voinescuvoinea/flatpack-oven/docs/concepts/estimates.md

# Concept estimates (generated by `geometry/concepts.py`, do not edit by hand)

Exchange rates: ECB euro foreign exchange reference rates, 2026-11-06: 1 EUR = 5.3403 RON = 1.1165 USD.

## Floor fit (round floor, fire taking 1/4 of the floor as in Falciano et al. 2022)
- Ø 0.90 m floor: fire segment depth 26.8 cm; largest clear circle beside it 63.2 cm,
  so a 45 cm pizza gets a 9.1 cm margin all round.

## Comparison

| | A | B | C |
|---|---|---|---|
| Concept | Steel-lined low dome | Firebrick barrel vault (sprung arch in a steel frame) | Cast refractory segment dome (home-cast in reusable moulds) |
| Refractory mass (kg) | 86 | 492 | 376 |
| Total estimated mass (kg) | 150 + hardware | 542 + hardware | 421 + hardware |
| Heaviest single part (kg) | 3.4 | 3.4 | 32.2 |
| Part count (approx.) | ~45 + fasteners | ~155 + fasteners | ~34 + fasteners |
| Stored heat at 450 °C, upper bound (MJ) | 40 | 229 | 175 |
| …as wood at F22 LHV and η (kg) | 2.8 | 15.8 | 12.1 |
| Priced items (USD) | 417 | 574 | 1259 |
| Unpriced items | inner liner; outer shell; laser cutting + bending of liner/shell; door | steel frame: angle buckstays + M12 tie rods; outer shell; door | moulds (plywood/EPS); outer shell; door |

## Line items

### A. Steel-lined low dome

Bolted stainless gores form a low dome over a firebrick floor; fibre insulation; painted steel outer shell. Like commercial portable ovens, scaled up.

Design parameters (proposals): `{'pizza_D_m': 0.45, 'door_w_m': 0.52, 'door_h_m': 0.24, 't_floor_brick_m': 0.064, 't_floor_casi_m': 0.05, 't_dome_sw_m': 0.075, 't_shell_m': 0.001, 'floor': 'round D 0.90 m', 'wall_h_m': 0.2, 'vault_rise_m': 0.2, 'liner_t_m': 0.0015}`

| Item | Qty | Mass (kg) | Cost (USD) |
|---|---|---|---|
| floor bricks (laid flat, 64 mm) | 25.0 pcs | 86.0 | 30 |
| floor insulation CaSi 2x25 mm | 3.0 sheets | 9.9 | 59 |
| inner liner, stainless 1.5 mm (8 gores + crown + door arch) | 1.6 m2 | 19.4 | quote needed |
| dome insulation Superwool 3x25 mm | 2.0 rolls | 18.0 | 313 |
| outer shell, steel 1 mm, painted | 2.1 m2 | 16.5 | quote needed |
| laser cutting + bending of liner/shell | 1.0 job | 0.0 | quote needed |
| refractory sealant | 2.0 cartridges | 0.0 | 16 |
| door, flue pipe, fasteners (A2 stainless) | 1.0 lot | 0.0 | quote needed |

### B. Firebrick barrel vault (sprung arch in a steel frame)

Local fireclay bricks dry-fitted on a reusable former, held by a bolted angle-iron frame with tie rods (kiln practice); fibre insulation; light outer shell.

Design parameters (proposals): `{'pizza_D_m': 0.45, 'door_w_m': 0.52, 'door_h_m': 0.24, 't_floor_brick_m': 0.064, 't_floor_casi_m': 0.05, 't_dome_sw_m': 0.075, 't_shell_m': 0.001, 'floor': 'rect 0.80 x 0.90 m, fire along back wall', 'wall_h_m': 0.15, 'vault_rise_m': 0.25, 'brick_t_m': 0.114, 'arch_radius_m': 0.445, 'arch_angle_deg': 128.0}`

| Item | Qty | Mass (kg) | Cost (USD) |
|---|---|---|---|
| floor bricks (laid flat, 64 mm) | 28.0 pcs | 96.3 | 34 |
| floor insulation CaSi 2x25 mm | 3.0 sheets | 11.2 | 59 |
| vault + walls, bricks (114 mm thick) | 115.0 pcs | 395.6 | 138 |
| dome insulation Superwool 3x25 mm | 2.0 rolls | 20.4 | 313 |
| steel frame: angle buckstays + M12 tie rods | 1.0 lot | 0.0 | quote needed |
| outer shell, steel 1 mm or cement board | 2.3 m2 | 18.7 | quote needed |
| refractory sealant / mortar for arch joints | 4.0 cartridges | 0.0 | 31 |
| door, flue pipe, fasteners | 1.0 lot | 0.0 | quote needed |

### C. Cast refractory segment dome (home-cast in reusable moulds)

8 dome segments + crown cast from dense castable in moulds (the commercial modular-kit approach); fibre insulation; outer shell or render.

Design parameters (proposals): `{'pizza_D_m': 0.45, 'door_w_m': 0.52, 'door_h_m': 0.24, 't_floor_brick_m': 0.064, 't_floor_casi_m': 0.05, 't_dome_sw_m': 0.075, 't_shell_m': 0.001, 'floor': 'round D 0.90 m', 'wall_h_m': 0.2, 'vault_rise_m': 0.2, 'shell_t_m': 0.08, 'segments': 9}`

| Item | Qty | Mass (kg) | Cost (USD) |
|---|---|---|---|
| floor bricks (laid flat, 64 mm) | 25.0 pcs | 86.0 | 30 |
| floor insulation CaSi 2x25 mm | 3.0 sheets | 9.9 | 59 |
| dome segments, dense castable 80 mm | 13.0 bags 25 kg | 290.1 | 834 |
| moulds (plywood/EPS), reinforcement needles | 1.0 lot | 0.0 | quote needed |
| dome insulation Superwool 3x25 mm | 2.0 rolls | 18.4 | 313 |
| outer shell, steel 1 mm or render on mesh | 2.1 m2 | 16.8 | quote needed |
| refractory sealant for segment joints | 3.0 cartridges | 0.0 | 24 |
| door, flue pipe, fasteners | 1.0 lot | 0.0 | quote needed |

## Notes on method
- Masses use mid-surface area x thickness x sourced density. Steel uses the 1.4301 density for all sheet.
- Stored heat assumes all hot-face refractory sits uniformly at 450 °C. That is an upper bound for
  comparing concepts, not a heat-up prediction (Phase 2). Steel is not counted (cp not yet sourced).
- 'Quote needed' items have no sourced price yet. They are listed, not guessed.
