voinescuvoinea/flatpack-oven/docs/interfaces.md

# Interfaces (generated by `geometry/interfaces.py`)

Coordinates: x across (0 = oven centre line), y front-to-back (0 = front edge of the cooking floor), z up (0 = top of the concrete base). Millimetres.

## R-I2: concrete base (built by the user)

- **Oven footprint on the base** (shell + frame): x -668 … 668, y -319 … 1239 → **1337 × 1558 mm**.
- **Recommended base top**: at least 1437 × 1858 mm (50 mm margin at the sides and back, a 250 mm landing in front of the door for the peel and tools).
- **Cooking floor height** = base top + 189 mm. A common Neapolitan working height is about elbow height; choose the base height for the main user.
- **Oven mass** (from the CAD model and sourced densities): **606 kg**, of which bricks 425 kg. Allow for people leaning on it: design the base for at least 909 kg spread over the footprint (1.5 × self-weight, an allowance, not a code value).
- **Anchors**: 4 buckstay foot cleats, 2 × M12 each, at x = ±644, y = -294 and 1214. Keep reinforcement and edges at least 100 mm away from the anchor holes.
- **Temperature**: the top of the concrete under the floor insulation reaches about 80–110 °C in long sessions (see `docs/reports/phase-3.md`). The 100 °C limit is an ASSUMPTION (K-28). Use ordinary concrete. Let it cure for at least 28 days, and dry before the first firing. Do not seal the top with plastic.
- **Water**: slope the top 1–2 % to the sides, or cast a 10 mm drip groove around the edge, so rain runoff does not collect under the floor insulation.

## R-I1: roof (separate project)

- **Flue**: Ø150 mm black-steel stove pipe, centre at x = 0, y = -380, starting at z = 589 mm above the base (top of the hood collar). The pipe carries gas at roughly 200–650 °C (model gas temperature during firing), so treat it as a hot flue.
- **Clearances**: follow the stove-pipe manufacturer's clearance to combustibles. Where the pipe passes a roof, use a certified double-wall (insulated) section and roof flashing. **Do not build a closed shelter**: the oven must stay in open air (R-S2, carbon monoxide).
- **Oven envelope**: 1497 (w) × 1779 (d) × 1589 (h) mm including the hood and 1 m pipe. Shell top 763 mm above the base. Leave at least 600 mm of free space in front for working with the peel.
- **Rain**: the shell and end panels shed rain, but the insulation must stay dry (K-06). The roof should keep driving rain off the door and hood area.

## Mass by family (kg)

| Family | kg |
|---|---|
| end wall bricks | 157.4 |
| vault bricks | 110.1 |
| floor bricks | 96.3 |
| side wall bricks | 55.0 |
| floor insulation | 44.0 |
| vault insulation | 39.2 |
| frame | 27.7 |
| shell | 25.4 |
| end insulation | 24.4 |
| door and flue | 14.5 |
| thrust strips | 6.0 |
| skewback bricks | 5.9 |
