voinescuvoinea/flatpack-oven/docs/decisions/0005-phase-3-choices.md

# 0005: Phase 3 choices

Date: 2026-11-07. Status: accepted (user: "always choose performance").

- R-F1 amended: the only wet work is filling marked joints with ready-mixed refractory
  mortar (vault V-joints, door arch, front wall). Everything else is dry, numbered and pre-cut.
- Floor insulation increased to 5 × 25 mm CaSi (125 mm). The concrete base runs cooler, and
  the floor loses less heat.
- Quote requests drafted (bom/quote_requests_ro.md) to close the budget before purchase.
- Standing preference: when options trade performance against convenience, choose
  performance; ask only for scope, safety or large budget changes.
