voinescuvoinea/flatpack-oven/bom/bom.md

# Bill of materials - oven B (generated by `bom/build_bom.py`, do not edit by hand)

Prices converted with ECB euro foreign exchange reference rates, 2026-11-06. 'QUOTE' = no sourced price yet (never guessed).

| Group | Item | Qty | Unit | USD | Note |
|---|---|---|---|---|---|
| Refractory | Fireclay brick Refarom 65 SA 230x114x64 | 150 | pcs | 180 | 135.5 in the model (floor bricks 28, side wall bricks 16, skewback bricks 8, vault bricks 32, back wall 31, front wall 16, door arch 4.5) + 10% spares |
| Refractory | Helios refractory mortar MC-29A, 25 kg | 1 | bags | 7 | V-joints of vault (4.8 L) and door arch (1.4 L), front-wall joints; 2.0 kg/L is an ASSUMPTION |
| Refractory | Fermit stove sealant 310 ml (hood-to-front-wall joint) | 2 | cartridges | 16 |  |
| Insulation | CaSi board CS-270 1200x600x25 | 12 | sheets | 236 | floor 5 layers + thrust strips = 185 L + 15% waste |
| Insulation | Superwool Plus blanket 128 kg/m3, 25 mm, roll 7.32 x 0.61 m | 2 | rolls | 313 | 8.5 m2 of 25 mm (2 layers on vault, sides, ends) |
| Insulation | ROCKWOOL ProRox WM 960ES wired mat, 100 mm (or 2 x 50 mm) | 4.58 | m2 | QUOTE | outer layer; mesh side outwards |
| Insulation | Superwool 6 mm blanket/paper strips for 5 mm expansion gaskets | 0.52 | m2 | QUOTE | floor perimeter, vault-to-end-wall and side-wall-to-end-wall joints |
| Steel frame | Angle L50x50x5 S235 (2 skewback rails + 4 buckstays), cut list in cut_list.md | 6.97 | m | QUOTE | 25 kg incl. 4 x 100 mm foot cleats |
| Steel frame | Threaded rod M12 (tie rods) | 2.99 | m | QUOTE | zinc-plated OK (outside shell) |
| Steel frame | Disc springs DIN 2093 for M12 (Di 12.2 mm), stacked in series for >= 8 mm travel | 24 | pcs | QUOTE | arch thrust ~0.35 kN per rod; choose spring size for ~0.4 kN preload at mid-travel |
| Steel frame | M12 nuts + large washers; M10 bolts for rail-to-buckstay joints | 1 | set | QUOTE |  |
| Steel frame | M12 anchors for buckstay foot cleats (chemical or expansion) | 8 | pcs | QUOTE | positions in base interface drawing |
| Shell | Pre-painted flat steel roofing sheet 0.5 mm (barrel shell) | 3.38 | m2 | QUOTE | paint emissivity ~0.92; no aluminium-look paint (low emissivity) |
| Shell | Steel sheet 1 mm for end panels (DXF) | 1.49 | m2 | QUOTE |  |
| Shell | Self-drilling screws with EPDM washers for shell | 60 | pcs | QUOTE |  |
| Door & flue | Steel sheet 1 mm for door box + Superwool offcut filling, 2 wooden handles | 1 | set | QUOTE | 1.9 kg steel |
| Door & flue | Black steel sheet 2 mm for flue hood (DXF), NOT galvanized | 0.44 | m2 | QUOTE | 7.0 kg |
| Door & flue | Stove pipe Ø150 black steel 1 m + rain cap (roof interface R-I1) | 1 | set | QUOTE |  |
| Finishes | Heat-resistant paint (frame, hood, pipe) | 1 | set | QUOTE |  |
| Temporary | Arch former: 18 mm plywood (3 ribs from DXF) + slats + wedges | 1 | set | QUOTE | reusable for repairs |

**Priced subtotal: 752 USD** of the ~1000 USD budget (R-C1). 15 lines still need quotes.

Excluded by scope: concrete base (R-F4), roof (R-E1), measurement kit (separate line, Phase 4).
