voinescuvoinea/flatpack-oven/bom/quote_requests_ro.md

# Cereri de ofertă - cuptor pe lemne (generat de `bom/quote_requests.py`)

Cuptor de pizza pe lemne, construit de o persoană fizică. Mai jos este câte un text de copiat în e-mail sau mesaj pentru fiecare tip de furnizor. Cantitățile provin din modelul CAD.

Total deja estimat din prețuri publice: 752 USD. Bugetul total este de aproximativ 1000 USD.

## Distribuitor de izolații tehnice (ROCKWOOL Technical Insulation / refractare)

> Bună ziua,
>
> Vă rog să-mi trimiteți o ofertă de preț (cu TVA) și termenul de livrare/ridicare în [oraș] pentru:
>
> - Saltea vată bazaltică cu plasă ROCKWOOL ProRox WM 960ES (sau WM 960), grosime 100 mm (sau 2 × 50 mm); variantă cu plasă din inox, dacă este disponibilă: **4,58 m²**
> - Superwool Plus (fibră bio-solubilă, AES) 6 mm, saltea sau hârtie, pentru garnituri de dilatație: **0,52 m²**
>
> Mulțumesc,
> [nume, telefon]

## Depozit de metale / atelier de debitare (local)

> Bună ziua,
>
> Vă rog să-mi trimiteți o ofertă de preț (cu TVA) și termenul de livrare/ridicare în [oraș] pentru:
>
> - Cornier oțel S235 L50×50×5 mm, debitat conform listei de mai jos: **6,97 m**
> - Tablă plană vopsită (pentru acoperiș) 0,5 mm, culoare închisă, NU culoare aluminiu: **3,38 m²**
> - Tablă neagră DC01 1 mm, debitată după DXF (2 panouri frontale/spate), opțional debitare laser: **1,49 m²**
> - Tablă neagră 1 mm pentru ușă (cutie 50 mm adâncime, după DXF) + 2 mânere din lemn: **1 set**
> - Tablă neagră 2 mm pentru hotă (după DXF hood_parts), NU zincată, opțional îndoire: **0,44 m²**
>
> Debitare cornier: 2 × 1558 mm, 4 × 863 mm, 4 × 100 mm (sau bare întregi, debitez eu).
> Fișierele DXF pentru tablă le pot trimite la cerere.
>
> Mulțumesc,
> [nume, telefon]

## Magazin de bricolaj sau feronerie (Dedeman, Hornbach, Leroy Merlin, magazine locale)

> Bună ziua,
>
> Vă rog să-mi trimiteți o ofertă de preț (cu TVA) și termenul de livrare/ridicare în [oraș] pentru:
>
> - Tijă filetată M12 zincată: **2,99 m**
> - Arcuri disc (șaibe Belleville) DIN 2093 pentru M12, diametru interior 12,2 mm: **24 buc**
> - Set piulițe M12 + șaibe mari; 8 șuruburi M10 × 30 cu piuliță și șaibă: **1 set**
> - Ancore M12 pentru beton (chimice sau mecanice): **8 buc**
> - Șuruburi autoforante pentru tablă, cu garnitură EPDM: **60 buc**
> - Vopsea rezistentă la temperatură (min. 600 °C) pentru cadru, hotă și burlan: **1 set**
> - Placaj 18 mm (aprox. 1200 × 600 mm) + șipci 20 × 40 mm (6 × 1 m) + pene de lemn: **1 set**
>
> Mulțumesc,
> [nume, telefon]

## Magazin de șeminee și coșuri de fum

> Bună ziua,
>
> Vă rog să-mi trimiteți o ofertă de preț (cu TVA) și termenul de livrare/ridicare în [oraș] pentru:
>
> - Burlan/țeavă de fum din oțel negru Ø150 mm, 1 m, + căciulă de ploaie (NU zincat): **1 set**
>
> Mulțumesc,
> [nume, telefon]

## Note

- Nu folosiți tablă sau burlan **zincat** pentru hotă și coș (vapori de zinc la temperatură).
- Tabla exterioară (carcasa) rămâne rece (sub 60 °C), deci acolo tabla vopsită sau zincată este acceptabilă.
- Rezultatele (preț, magazin, dată) se trec în `materials/materials.yaml`, la `suppliers`, apoi se regenerează BOM-ul.
