voinescuvoinea/flatpack-oven/bom/dxf/door_front.dxf

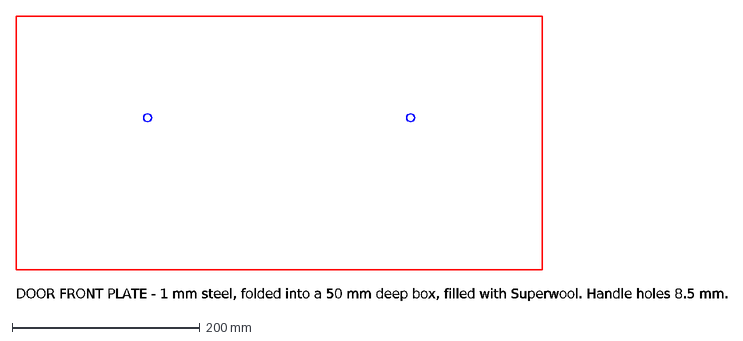
[picture p4: CAD file, 2026-11-07]
bom/dxf/door_front.dxf
DOOR FRONT PLATE - 1 mm steel, folded into a 50 mm deep box, filled with Superwool. Handle holes 8.5 mm.
