voinescuvoinea/flatpack-oven/bom/dxf/end_wall_front.dxf

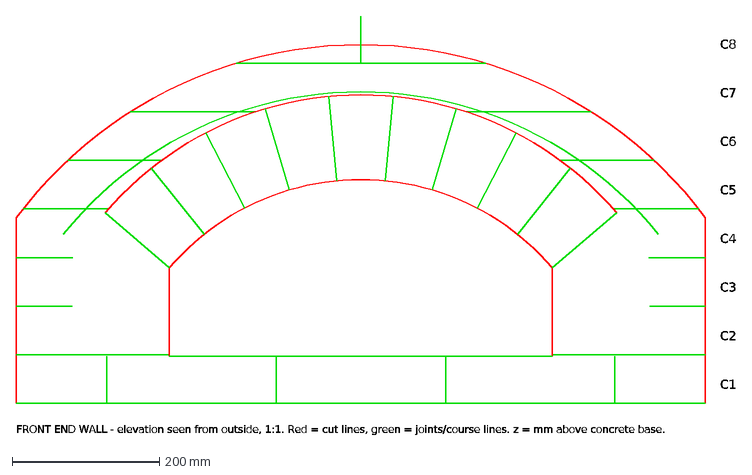
[picture p5: CAD file, 2026-11-07]
bom/dxf/end_wall_front.dxf
C1
C2
C3
C4
C5
C6
C7
C8
FRONT END WALL - elevation seen from outside, 1:1. Red = cut lines, green = joints/course lines. z = mm above concrete base.
