voinescuvoinea/flatpack-oven/bom/dxf/former_rib.dxf

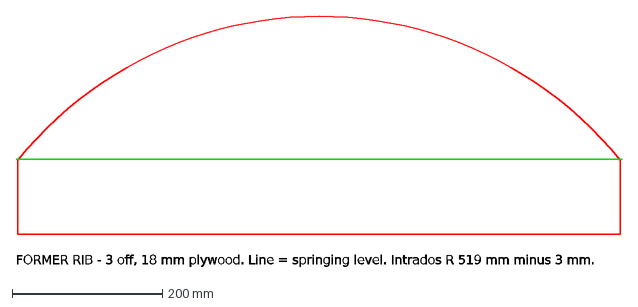
[picture p6: CAD file, 2026-11-07]
bom/dxf/former_rib.dxf
FORMER RIB - 3 off, 18 mm plywood. Line = springing level. Intrados R 519 mm minus 3 mm.
