voinescuvoinea/flatpack-oven/bom/dxf/hood_parts.dxf

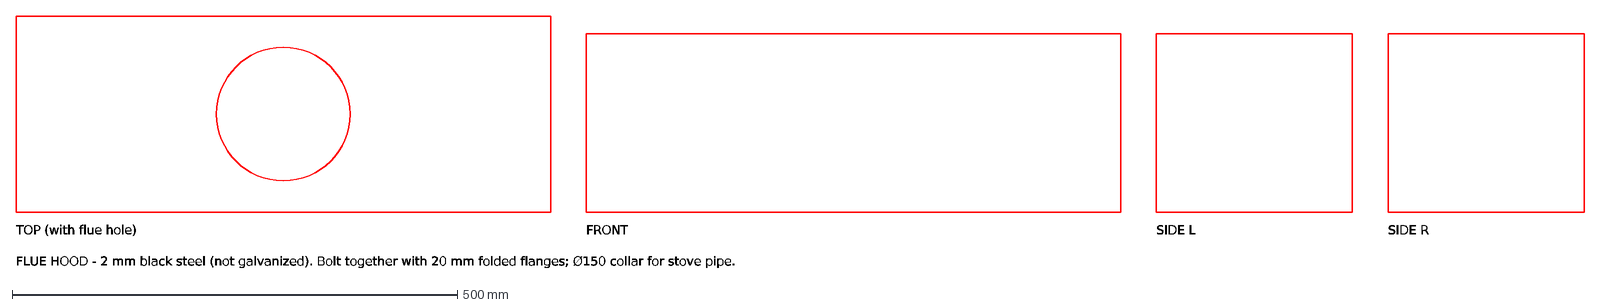
[picture p7: CAD file, 2026-11-07]
bom/dxf/hood_parts.dxf
TOP (with flue hole)
FRONT
SIDE L
SIDE R
FLUE HOOD - 2 mm black steel (not galvanized). Bolt together with 20 mm folded flanges; Ø150 collar for stove pipe.
