voinescuvoinea/flatpack-oven/bom/dxf/end_panel_front.dxf

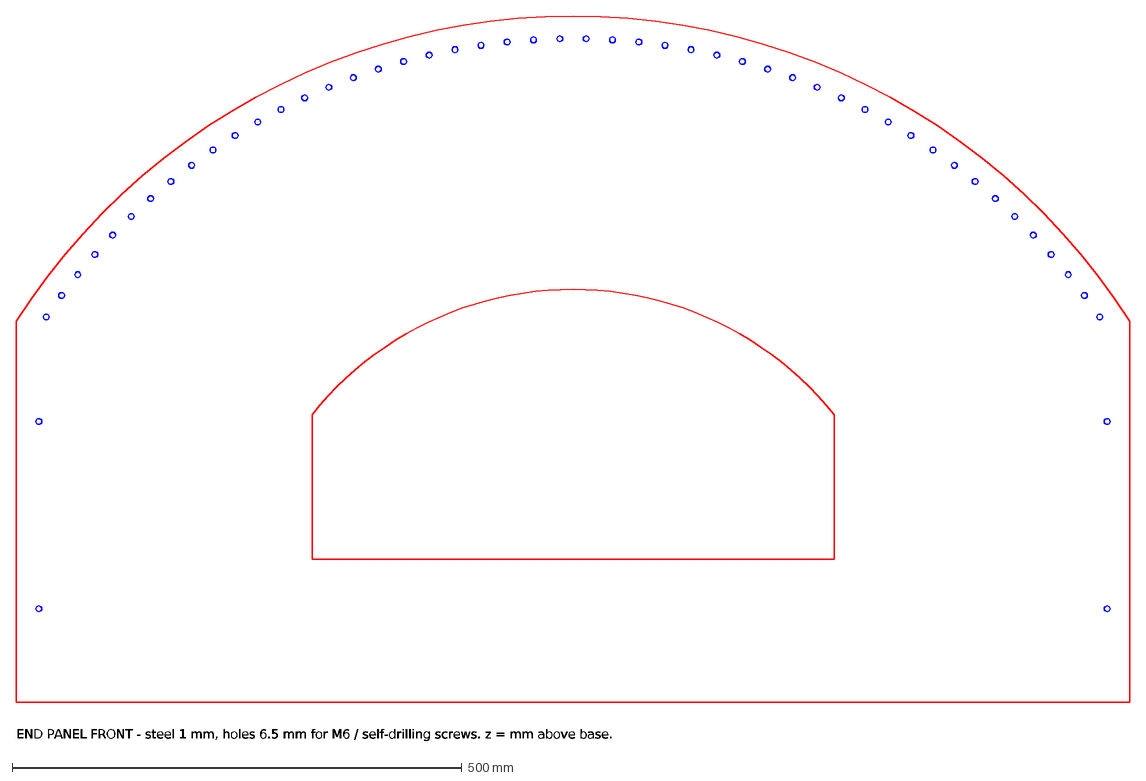
[picture p8: CAD file, 2026-11-07]
bom/dxf/end_panel_front.dxf
END PANEL FRONT - steel 1 mm, holes 6.5 mm for M6 / self-drilling screws. z = mm above base.
