voinescuvoinea/flatpack-oven/bom/dxf/end_wall_back.dxf

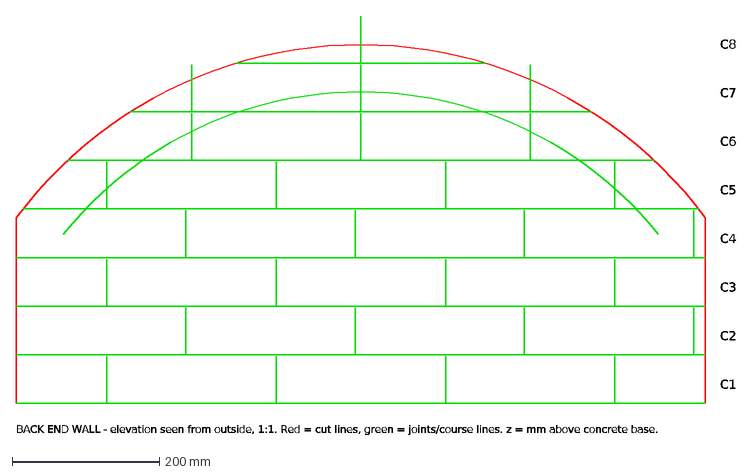
[picture p9: CAD file, 2026-11-07]
bom/dxf/end_wall_back.dxf
C1
C2
C3
C4
C5
C6
C7
C8
BACK END WALL - elevation seen from outside, 1:1. Red = cut lines, green = joints/course lines. z = mm above concrete base.
