voinescuvoinea/flatpack-oven/bom/dxf/skewback_template.dxf

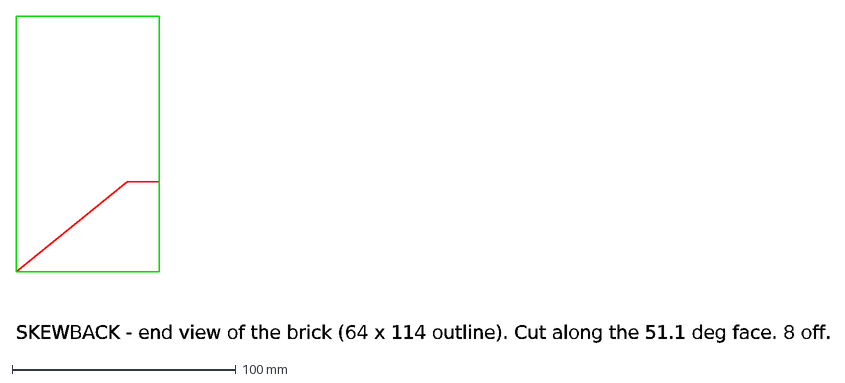
[picture p10: CAD file, 2026-11-07]
bom/dxf/skewback_template.dxf
SKEWBACK - end view of the brick (64 x 114 outline). Cut along the 51.1 deg face. 8 off.
