voinescuvoinea/flatpack-oven/bom/dxf/shell_sheet.dxf

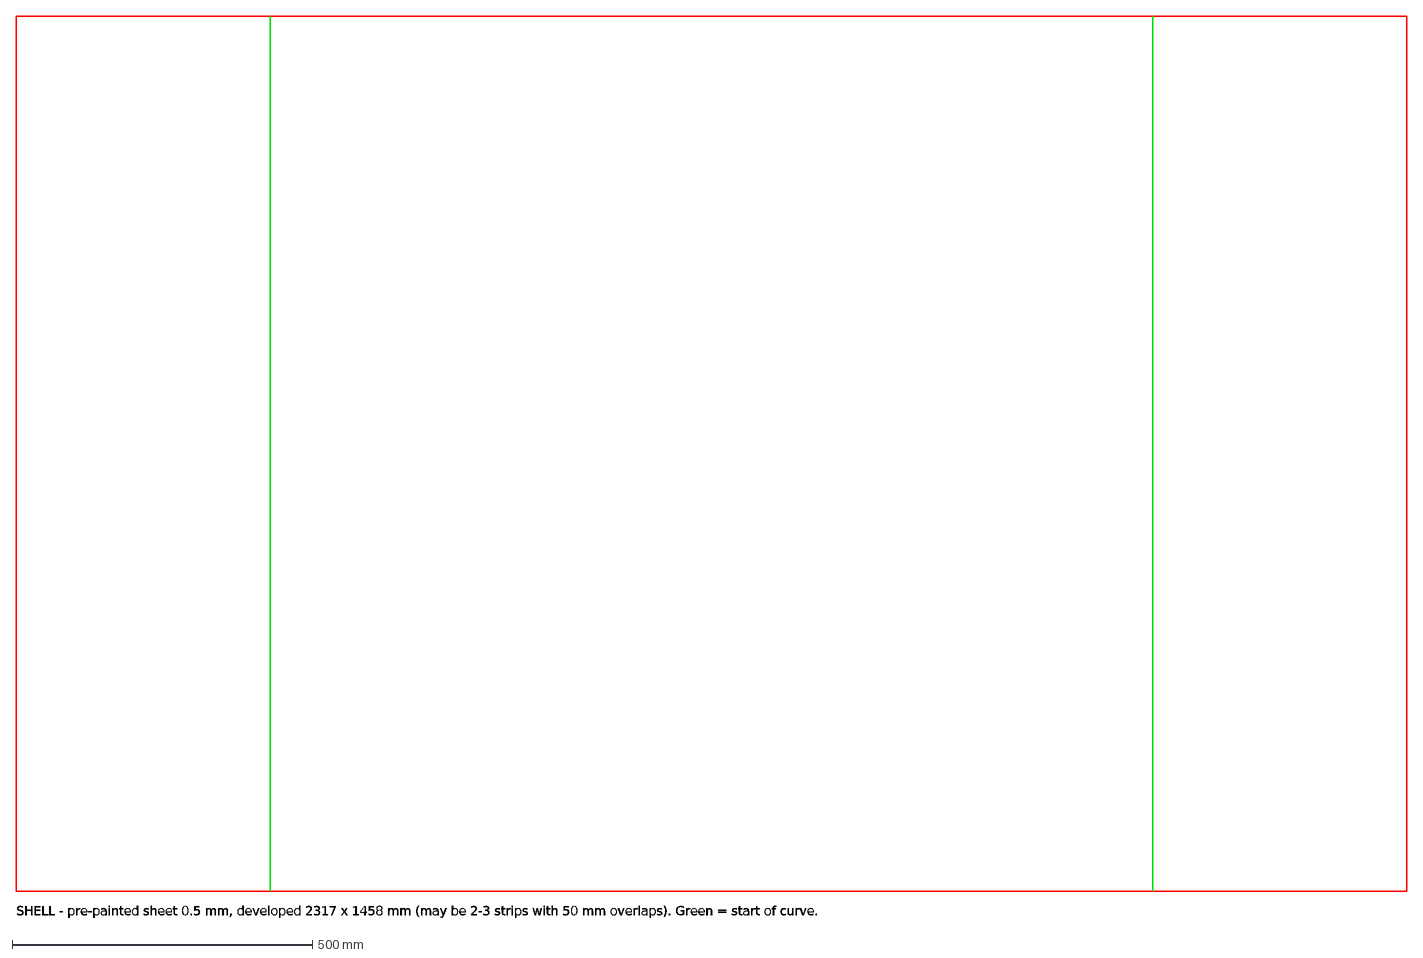
[picture p11: CAD file, 2026-11-07]
bom/dxf/shell_sheet.dxf
SHELL - pre-painted sheet 0.5 mm, developed 2317 x 1458 mm (may be 2-3 strips with 50 mm overlaps). Green = start of curve.
