voinescuvoinea/flatpack-oven/bom/dxf/end_panel_back.dxf

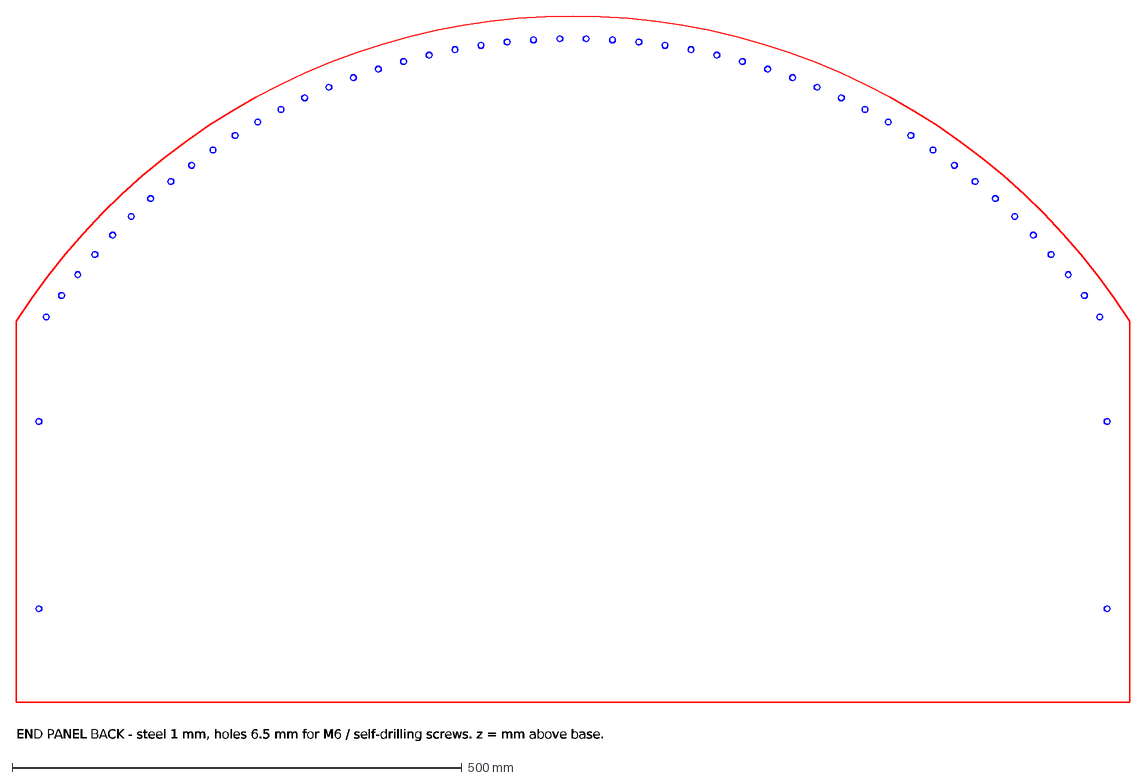
[picture p12: CAD file, 2026-11-07]
bom/dxf/end_panel_back.dxf
END PANEL BACK - steel 1 mm, holes 6.5 mm for M6 / self-drilling screws. z = mm above base.
