voinescuvoinea/flatpack-oven/docs/decisions/0003-no-coupon-test.md

# 0003: Skip the Phase 1.5 coupon test

Date: 2026-11-07. Status: accepted (user).

## Consequences
- Brick thermal properties stay proxy values (K-18) until the first real firing.
- The Phase 4 measurement plan becomes the first calibration point, so it
  must be thorough enough to fit floor and vault properties afterwards (Phase 5).
- The curing/first-firing procedure doubles as the material check: slow
  ramps, with inspection for cracking and spalling before full temperature.
