voinescuvoinea/flatpack-oven/(commit log)

2026-11-07 Flat-pack wood-fired oven: phases 0-3 (requirements to detailed design)
    Requirements, sourced materials database, verified thermal model
    calibrated on published oven data, parametric CadQuery model of the
    brick barrel-vault oven, BOM, cut list, DXF templates, interface specs,
    risks and decision records. Built with Claude Code.
    [bom.csv, door_front.dxf, end_panel_back.dxf, end_panel_front.dxf, end_wall_back.dxf, end_wall_front.dxf, former_rib.dxf, hood_parts.dxf]
2026-11-07 Add interactive project explorer (explorer/index.html)
    - Self-contained HTML page generated from the project data: overview,
    3D model (layers, explode, section cut, click to identify), heat-up
    and calibration charts, sensitivity, what-if sliders, brickwork
    cross-section and end-wall elevations, materials with sources,
    parts list and budget, requirements, risks and decisions
    - explorer/sweeps.py precomputes model runs for the sliders
    - explorer/build.py fills explorer/template.html; README documents it
    [door_front.dxf, end_panel_back.dxf, end_panel_front.dxf, end_wall_back.dxf, end_wall_front.dxf, former_rib.dxf, hood_parts.dxf, shell_sheet.dxf]
